colinvignoul/osu-ece342-oscilloscope/Oscilloscope User Interface/Switch Libraries/MINI-SPDT-SW.step

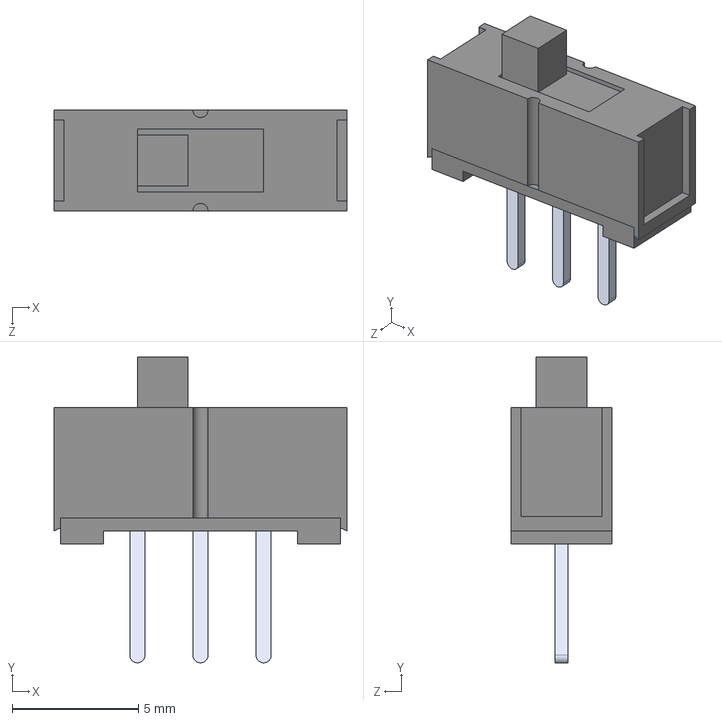
[picture p1: CAD file, 2026-05-02]
Oscilloscope User Interface/Switch Libraries/MINI-SPDT-SW.step
11.6 x 12.1 x 4.00 mm
