colinvignoul/osu-ece342-oscilloscope/PCB schematic/.step

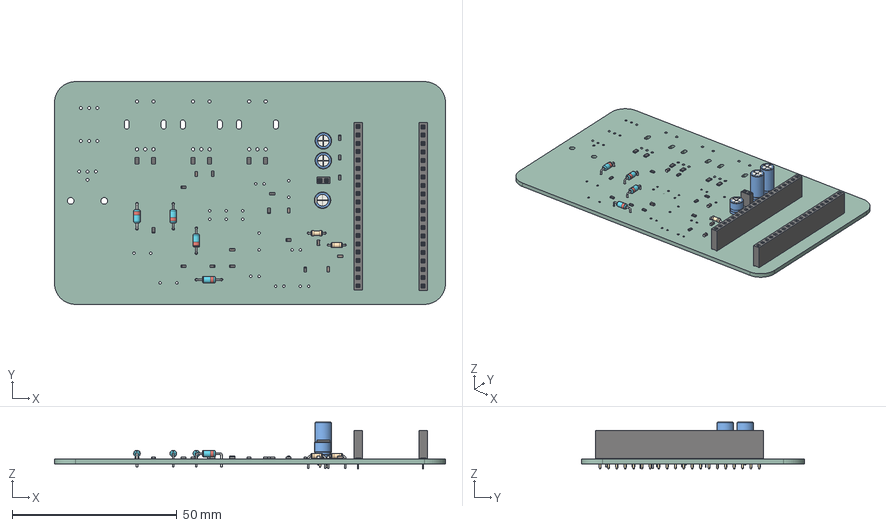
[picture p2: CAD file, 2026-05-27]
PCB schematic/.step
118.5 x 67.5 x 14.1 mm
R_0603_1608Metric x 13
PinSocket_1x20_P2.54mm_Vertical x 2
C_Radial_D5.0mm_H11.0mm_P2.00mm x 2
C_0603_1608Metric x 6
R_Axial_DIN0204_L3.6mm_D1.6mm_P5.08mm_Horizontal x 2
R_0805_2012Metric x 6
D_DO-35_SOD27_P7.62mm_Horizontal x 4
PinSocket_1x02_P2.00mm_Vertical
CP_Radial_D5.0mm_P2.50mm
input_conditioning_r2_PCB
