colinvignoul/osu-ece342-oscilloscope/(list of files, drawings)

Other design files:
PCB schematic/OPA365/opa365.dsn
PCB schematic/OPA365/opa365.opj
