colinvignoul/osu-ece342-oscilloscope/PCB schematic/input_conditioning_r2.kicad_pcb

## KiCad design PCB schematic/input_conditioning_r2.kicad_pcb (2026-05-07)

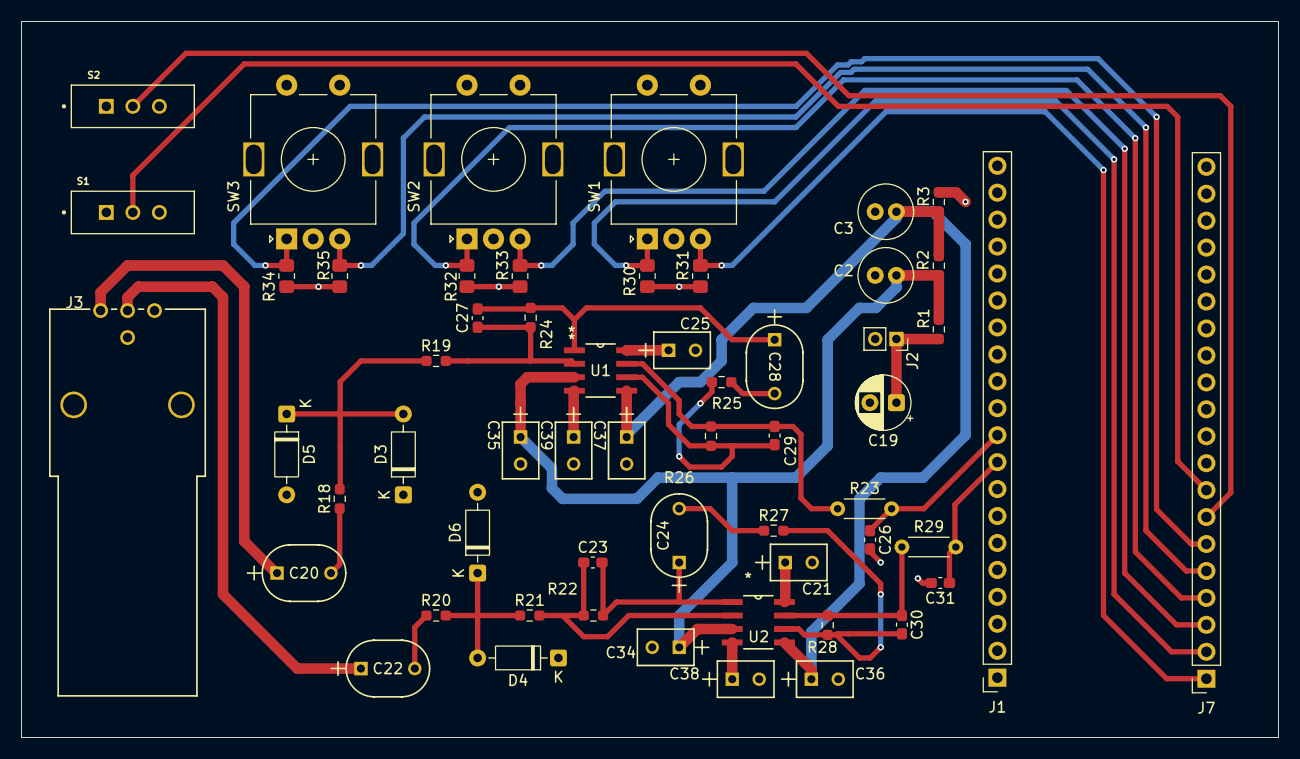
[picture p3: board input_conditioning_r2.kicad_pcb from above]

Board: 4 copper layers, 118.5 x 67.5 mm, 57 parts (0 on the bottom side), 31 nets.

Parts:
C2, C3: 1u; C_Radial_D5.0mm_H11.0mm_P2.00mm
C19: 10u; CP_Radial_D5.0mm_P2.50mm
C20, C22, C24, C28: 1u; CAP_C330_KEM
C21, C25, C34, C35, C36, C37, C38, C39: 100n; CAP_AR20_AVX
C23, C27: 20p; C_0603_1608Metric_Pad1.08x0.95mm_HandSolder
C26, C31: 680p; C_0603_1608Metric_Pad1.08x0.95mm_HandSolder
C29, C30: 33p; C_0603_1608Metric_Pad1.08x0.95mm_HandSolder
D3, D4, D5, D6: 1N4148; D_DO-35_SOD27_P7.62mm_Horizontal
J1: Conn_01x10_Socket; PinSocket_1x20_P2.54mm_Vertical
J2: Conn_01x02_Socket; PinSocket_1x02_P2.00mm_Vertical
J3: Conn_Coaxial_x2; CONN_6575_AMP
J7: Conn_01x08_Socket; PinSocket_1x20_P2.54mm_Vertical
R1, R22, R24, R25, R27: 100k; R_0603_1608Metric_Pad0.98x0.95mm_HandSolder
R2, R3: 50k; R_0603_1608Metric_Pad0.98x0.95mm_HandSolder
R18, R19, R20, R21, R26, R28: 47k; R_0603_1608Metric_Pad0.98x0.95mm_HandSolder
R23, R29: 100; R_Axial_DIN0204_L3.6mm_D1.6mm_P5.08mm_Horizontal
R30, R31, R32, R33, R34, R35: 5k; R_0805_2012Metric_Pad1.20x1.40mm_HandSolder
S1, S2: MINI-SPDT-SW; SW_MINI-SPDT-SW
SW1: Shifting; RotaryEncoder_Alps_EC11E-Switch_Vertical_H20mm
SW2: Scaling; RotaryEncoder_Alps_EC11E-Switch_Vertical_H20mm
SW3: Trigger; RotaryEncoder_Alps_EC11E-Switch_Vertical_H20mm
U1, U2: OPA2365AID; D8

Connections:
+2V5: C2.1, C34.1, C35.1, R1.2, R2.1, U1.3 (INA+), U2.3 (INA+)
+3V3: J1.5, R30.1, R31.1, R32.1, R33.1, R34.1, R35.1, S1.1, S2.1
+5V: C19.1, C21.1, C25.1, D3.1 (K), D4.1 (K), J1.2, J2.1, R1.1, U1.8 (V+), U2.8 (V+)
/+1V25: C3.1, C36.1, C37.1, R2.2, R3.1, U1.5 (INB+), U2.5 (INB+)
/Real Signal Processing 1/ac_coupled: D3.2 (A), D5.1 (K), R18.2, R19.1
/Real Signal Processing 1/s1_in: C27.1, R19.2, R24.1, U1.2 (INA-)
/Real Signal Processing 1/s1_out: C27.2, C28.1, R24.2, U1.1 (VOUTA)
/Real Signal Processing 1/s2_in: C29.2, R25.2, R26.2, U1.6 (INB-)
/Real Signal Processing 1/s2_out: C29.1, R23.1, R26.1, U1.7 (VOUTB)
/Real Signal Processing 2/ac_coupled: D4.2 (A), D6.1 (K), R20.2, R21.1
/Real Signal Processing 2/s1_in: C23.1, R21.2, R22.1, U2.2 (INA-)
/Real Signal Processing 2/s1_out: C23.2, C24.1, R22.2, U2.1 (VOUTA)
/Real Signal Processing 2/s2_in: C30.2, R27.2, R28.2, U2.6 (INB-)
/Real Signal Processing 2/s2_out: C30.1, R28.1, R29.1, U2.7 (VOUTB)
/input_1: C20.1, J3.1 (IN1)
/input_2: C22.1, J3.2 (IN2)
/output_1: C26.1, J1.10, R23.2
/output_2: C31.1, J1.9, R29.2
GND: C2.2, C3.2, C19.2, C21.2, C25.2, C26.2, C31.2, C34.2, C35.2, C36.2, C37.2, C38.1, C38.2, C39.1, C39.2, D5.2 (A), D6.2 (A), J1.3, J2.2, J3.3 (EXT), R3.2, S1.3, S2.3, SW1.C, SW2.C, SW3.C, U1.4 (V-), U2.4 (V-)
unnamed: C20.2, R18.1
unnamed: C22.2, R20.1
unnamed: C24.2, R27.1
unnamed: C28.2, R25.1
unnamed: J7.1, R31.2, SW1.B
unnamed: J7.2, R30.2, SW1.A
unnamed: J7.3, R33.2, SW2.B
unnamed: J7.4, R32.2, SW2.A
unnamed: J7.5, R35.2, SW3.B
unnamed: J7.6, R34.2, SW3.A
unnamed: J7.7, S2.2
unnamed: J7.8, S1.2
