colinvignoul/osu-ece342-oscilloscope/Oscilloscope User Interface/Oscilloscope User Interface.kicad_pcb

## KiCad design Oscilloscope User Interface/Oscilloscope User Interface.kicad_pcb (2026-05-05)

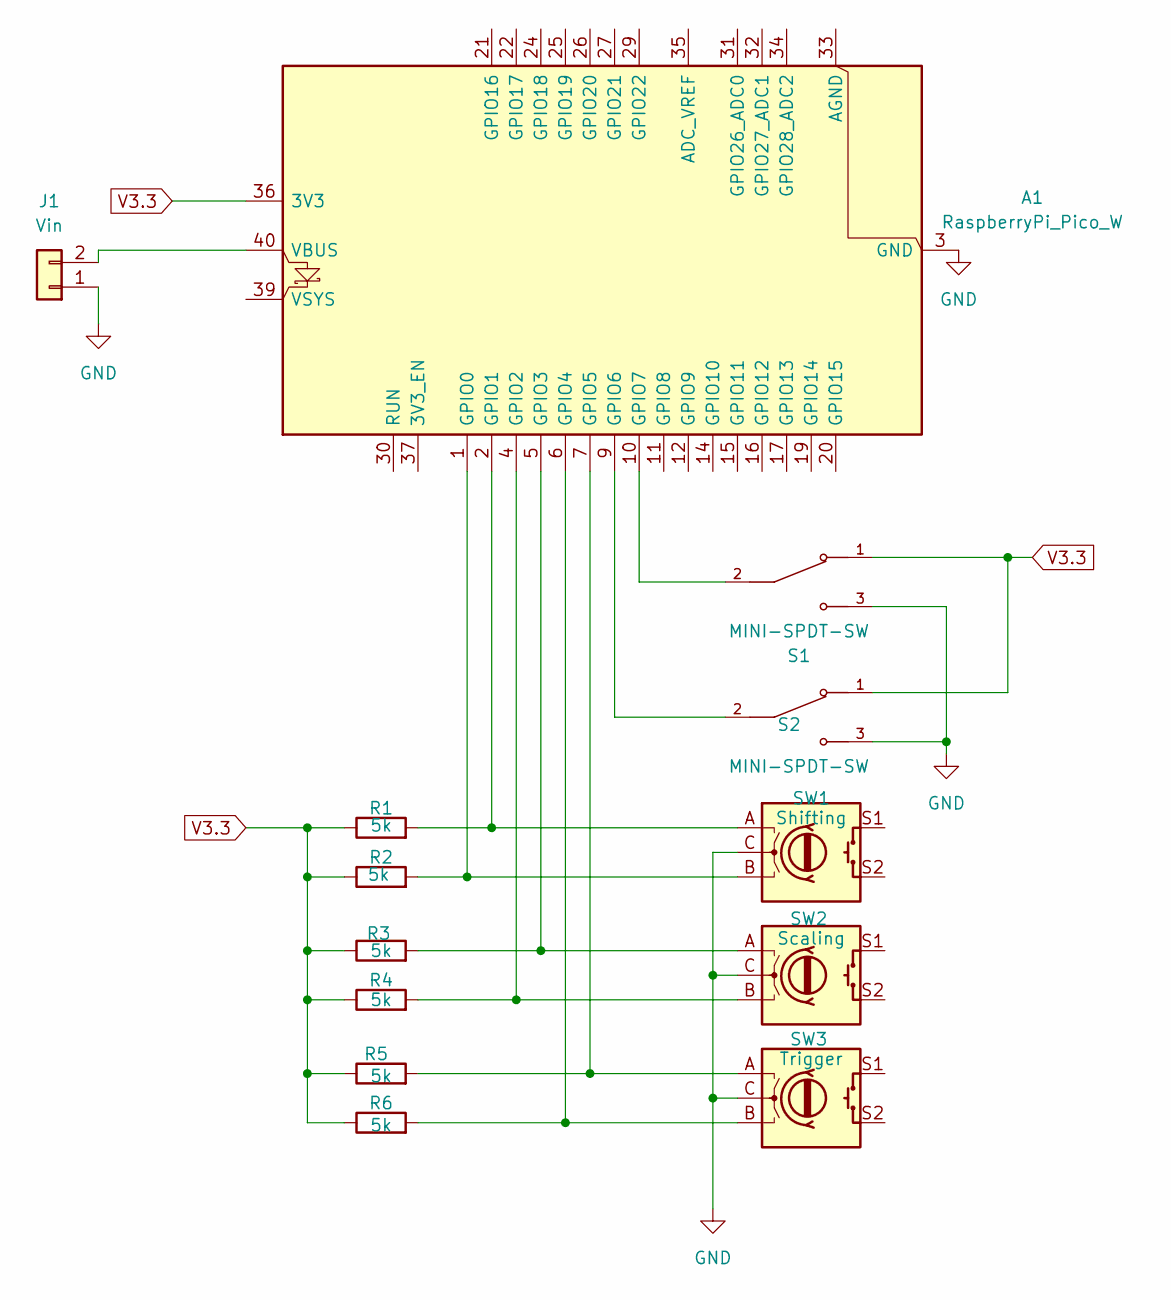
[picture p4: schematic Oscilloscope User Interface.kicad_sch]

Parts:
A1: RaspberryPi_Pico_W; RaspberryPi_Pico_W_SMD_HandSolder
J1: Vin; PinHeader_1x02_P2.54mm_Vertical
R1, R2, R3, R4, R5, R6: 5k; R_0201_0603Metric
S1, S2: MINI-SPDT-SW; SW_MINI-SPDT-SW
SW1: Shifting; RotaryEncoder_Alps_EC11E-Switch_Vertical_H20mm
SW2: Scaling; RotaryEncoder_Alps_EC12E-Switch_Vertical_H20mm
SW3: Trigger; RotaryEncoder_Alps_EC12E-Switch_Vertical_H20mm

Connections:
GND: A1.3 (GND), A1.8 (GND), A1.13 (GND), A1.18 (GND), A1.23 (GND), A1.28 (GND), A1.38 (GND), J1.1, S1.3, S2.3, SW1.C, SW2.C, SW3.C
unnamed: A1.1 (GPIO0), R2.2, SW1.B
unnamed: A1.2 (GPIO1), R1.2, SW1.A
unnamed: A1.4 (GPIO2), R4.2, SW2.B
unnamed: A1.5 (GPIO3), R3.2, SW2.A
unnamed: A1.6 (GPIO4), R6.2, SW3.B
unnamed: A1.7 (GPIO5), R5.2, SW3.A
unnamed: A1.9 (GPIO6), S2.2
unnamed: A1.10 (GPIO7), S1.2
unnamed: A1.40 (VBUS), J1.2
V3.3: A1.36 (3V3), R1.1, R2.1, R3.1, R4.1, R5.1, R6.1, S1.1, S2.1

Board: 2 copper layers, 13 parts (0 on the bottom side), 11 nets, no tracks yet.
