colinvignoul/osu-ece342-oscilloscope/(commit log)

2026-04-24 "Added LED blinking to check if working"
2026-04-26 "Updated ui and started adc code with dma."
2026-04-27 Initial commit of current design for the signal processing block
    [RP2040.kicad_sch, input_conditioning_r2.kicad_sch, opa365.dsn, opa365.opj, probe_sim.kicad_sch, real_signal_processing.kicad_sch, signal_processing.kicad_sch]
2026-04-27 Refactor and polishing
    [RP2040.kicad_sch, input_conditioning_r2.kicad_sch, real_signal_processing.kicad_sch, signal_processing.kicad_sch]
2026-04-28 "Added some new files from the internet for working with dma"
2026-05-01 updated with available part sizes
    [input_conditioning_r2.kicad_sch, real_signal_processing.kicad_sch, signal_processing.kicad_sch]
2026-05-02 "Added UI schematic"
    [MINI-SPDT-SW.step, Oscilloscope User Interface.kicad_pcb, Oscilloscope User Interface.kicad_sch, input_conditioning_r2.kicad_sch, opa365.dsn, opa365.opj, probe_sim.kicad_sch, real_signal_processing.kicad_sch]
2026-05-02 "Updated UI schematic"
    [Oscilloscope User Interface.kicad_sch]
2026-05-04 "Deleted Main Code"
    [Oscilloscope User Interface.kicad_pcb]
2026-05-04 schematic layout mostly done
    [input_conditioning_r2.kicad_pcb, input_conditioning_r2.kicad_sch, real_signal_processing.kicad_sch]
2026-05-05 "Updated UI part of PCB"
    [input_conditioning_r2.kicad_pcb]
2026-05-05 oscilloscope ui PCB update
2026-05-06 pcb initial complete revision
    [input_conditioning_r2.kicad_pcb, input_conditioning_r2.kicad_sch, real_signal_processing.kicad_sch, signal_processing.kicad_sch]
2026-05-06 Fixed encoder footprints
2026-05-06 pcb fixed encoder footprints
    [input_conditioning_r2.kicad_pcb]
2026-05-07 pcb almost ready to order
    [input_conditioning_r2.kicad_pcb]
2026-05-07 pcb finished
    [input_conditioning_r2-B_Cu.gbr, input_conditioning_r2-B_Mask.gbr, input_conditioning_r2-B_Paste.gbr, input_conditioning_r2-B_Silkscreen.gbr, input_conditioning_r2-Edge_Cuts.gbr, input_conditioning_r2-F_Cu.gbr, input_conditioning_r2-F_Mask.gbr, input_conditioning_r2-F_Paste.gbr]
2026-05-27 Implement DMA to drive SPI and flash screen at perhaps yet higher a rate
2026-05-27 Rough demo of scaling, rendering samples from example array onto display
2026-05-27 "Idk small changes from just pulling up PCB schematic"
    [.step]
2026-05-30 "Finally got rotary encoder debouncing and interrupts working!"
2026-05-31 Update encoder and button behavior
2026-05-31 Update switch and encoder behavior
2026-05-31 Swap encoder behavior from vert/horz to shift/scale
    [config.hpp, encoder_manager.cpp, encoder_manager.hpp, scope_control.cpp, scope_types.hpp]
2026-06-02 Implement adaptive trigger noise reduction, interpolation at nominal timebases lower than 1
    [acquisition_engine.cpp, acquisition_engine.hpp, config.hpp, history_acquisition.cpp, main.cpp, scope_control.cpp, scope_control.hpp, scope_types.hpp]
2026-06-02 Update encoder behavior
2026-06-03 Add run/hold switch on GP8
